madcatse/Retro-laptop-musicbox/documents/15pin_cable_pinout.png

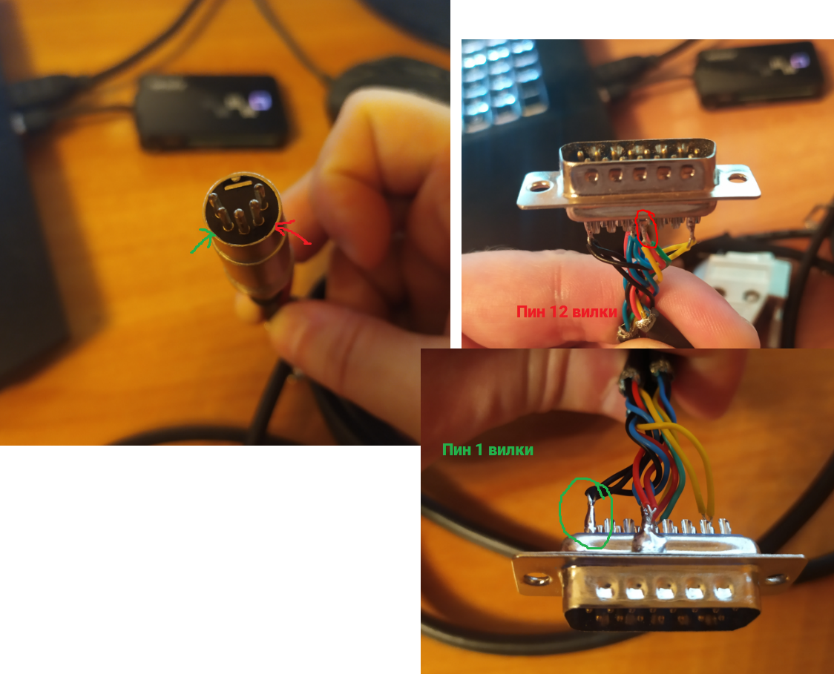
documents/15pin_cable_pinout.png
