madcatse/Retro-laptop-musicbox/README.md

# Retro-laptop-musicbox
 A stand-alone device that combines mt32-pi, LPT2MIDI and a COVOX
