madcatse/Retro-laptop-musicbox/documents/components_list.xlsx

Source: | C:\KICAD\projects\my_pcb\my_pcb.kicad_sch
Date: | 2023-03-08 17:43
Tool: | Eeschema (6.0.10)
Generator: | C:\Program Files\KiCad\6.0\bin\scripting\plugins/bom_csv_grouped_by_value.py
Component Count: | 72
Individual Components:
Item | Qty | Reference(s) | Value | LibPart | Footprint | Datasheet | Название
 |  | C1 | 470uF 25V | Device:C_Polarized | Capacitor_THT:CP_Radial_D10.0mm_P7.50mm | ~ | ECAP (К50-35), 470 мкФ, 25 В, 105°C, 10x12,5, B41851F5477M000, Конденсатор электролитический алюминиевый
 |  | C2 | 470uF 25V | Device:C_Polarized | Capacitor_THT:CP_Radial_D10.0mm_P7.50mm | ~ | ECAP (К50-35), 470 мкФ, 25 В, 105°C, 10x12,5, B41851F5477M000, Конденсатор электролитический алюминиевый
 |  | C3 | 0.1uF | Device:C | Capacitor_THT:C_Disc_D4.7mm_W2.5mm_P5.00mm | https://static.chipdip.ru/lib/056/DOC000056282.pdf | К10-17Б 0.1 мкФ X7R,10%, 0805, Конденсатор керамический выводной
 |  | C4 | 1000uF 25V | Device:C_Polarized | Capacitor_THT:CP_Radial_D10.0mm_P7.50mm | ~ | ECAP (К50-35), 1000 мкФ, 25 В, 105°C, 10x20, B41851A5108M000, Конденсатор электролитический алюминиевый
 |  | C5 | 0.1uF | Device:C | Capacitor_THT:C_Disc_D4.7mm_W2.5mm_P5.00mm | https://static.chipdip.ru/lib/056/DOC000056282.pdf | К10-17Б 0.1 мкФ X7R,10%, 0805, Конденсатор керамический выводной
 |  | C6 | 0.1uF | Device:C | Capacitor_THT:C_Disc_D4.7mm_W2.5mm_P5.00mm | https://static.chipdip.ru/lib/056/DOC000056282.pdf | К10-17Б 0.1 мкФ X7R,10%, 0805, Конденсатор керамический выводной
 |  | C7 | 1000uF 25V | Device:C_Polarized | Capacitor_THT:CP_Radial_D10.0mm_P7.50mm | ~ | ECAP (К50-35), 1000 мкФ, 25 В, 105°C, 10x20, B41851A5108M000, Конденсатор электролитический алюминиевый
 |  | C8 | 470pF | Device:C | Capacitor_THT:C_Disc_D4.7mm_W2.5mm_P5.00mm | https://static.chipdip.ru/lib/056/DOC000056282.pdf | К10-17Б 470пФ NPO,5%,0805, Конденсатор керамический выводной
 |  | C9 | 10uF 16V | Device:C_Polarized | Capacitor_THT:CP_Radial_D5.0mm_P2.00mm | https://static.chipdip.ru/lib/279/DOC000279577.pdf | ECAP (К50-35), 10мкФ, 16В, 105°C, 20%, 5x11мм P:2мм, Конденсатор электролитический алюминиевый
 |  | C10 | 100uF 63V | Device:C_Polarized | Capacitor_THT:CP_Radial_D10.0mm_P5.00mm | https://static.chipdip.ru/lib/279/DOC000279577.pdf | ECAP (К50-35), 100мкФ, 63В, 105°C, 20%, 10x12мм P:5мм, Конденсатор электролитический алюминиевый
 |  | C11 | 0.1uF | Device:C | Capacitor_THT:C_Disc_D4.7mm_W2.5mm_P5.00mm | https://static.chipdip.ru/lib/056/DOC000056282.pdf | К10-17Б 0.1 мкФ X7R,10%, 0805, Конденсатор керамический выводной
 |  | C12 | 0.1uF | Device:C | Capacitor_THT:C_Disc_D4.7mm_W2.5mm_P5.00mm | https://static.chipdip.ru/lib/056/DOC000056282.pdf | К10-17Б 0.1 мкФ X7R,10%, 0805, Конденсатор керамический выводной
 |  | C13 | 33nF | Device:C | Capacitor_THT:C_Disc_D4.7mm_W2.5mm_P5.00mm | https://static.chipdip.ru/lib/056/DOC000056282.pdf | К10-17Б 0.033мкФ X7R,10%,0805, Конденсатор керамический выводной
 |  | C14 | 10uF 16V | Device:C_Polarized | Capacitor_THT:CP_Radial_D5.0mm_P2.00mm | https://static.chipdip.ru/lib/279/DOC000279577.pdf | ECAP (К50-35), 10мкФ, 16В, 105°C, 20%, 5x11мм P:2мм, Конденсатор электролитический алюминиевый
 |  | C15 | 0.01uF | Device:C | Capacitor_THT:C_Disc_D4.7mm_W2.5mm_P5.00mm | https://static.chipdip.ru/lib/056/DOC000056282.pdf | К10-17Б 0.01 мкФ X7R,10%,0805, Конденсатор керамический выводной
 |  | C16 | 0.1uF | Device:C | Capacitor_THT:C_Disc_D4.7mm_W2.5mm_P5.00mm | https://static.chipdip.ru/lib/056/DOC000056282.pdf | К10-17Б 0.1 мкФ X7R,10%, 0805, Конденсатор керамический выводной
 |  | C17 | 1000uF 25V | Device:C_Polarized | Capacitor_THT:CP_Radial_D10.0mm_P7.50mm | ~ | ECAP (К50-35), 1000 мкФ, 25 В, 105°C, 10x20, B41851A5108M000, Конденсатор электролитический алюминиевый
 |  | C18 | 0.1uF | Device:C | Capacitor_THT:C_Disc_D4.7mm_W2.5mm_P5.00mm | https://static.chipdip.ru/lib/056/DOC000056282.pdf | К10-17Б 0.1 мкФ X7R,10%, 0805, Конденсатор керамический выводной
 |  | D1 | 1N4148 | Diode:1N4148 | Diode_THT:D_DO-35_SOD27_P7.62mm_Horizontal | https://static.chipdip.ru/lib/007/DOC003007981.pdf | 1N4148, Диод 150мА 100В [DO-35]
 |  | D2 | 1N4148 | Diode:1N4148 | Diode_THT:D_DO-35_SOD27_P7.62mm_Horizontal | https://static.chipdip.ru/lib/007/DOC003007981.pdf | 1N4148, Диод 150мА 100В [DO-35]
 |  | D3 | 1N4004 | Diode:1N4004 | Diode_THT:D_DO-41_SOD81_P10.16mm_Horizontal | http://www.vishay.com/docs/88503/1n4001.pdf | 1N4004, Диод выпрямительный 1А 400В [DO-41]
 |  | J1 | 12V Input Barrel | Connector:Barrel_Jack_MountingPin | w_conn_av:BarrelJack_GCT_DCJ200-10-A_Horizontal | https://static.chipdip.ru/lib/485/DOC014485047.pdf | DJK-02A (L-KLS1-DC-005A-2.0), Гнездо питания на плату 2,0х9мм
 |  | J2 | DB25_Male_MountingHoles | Connector:DB25_Male_MountingHoles | Connector_Dsub:DSUB-25_Male_Horizontal_P2.77x2.84mm_EdgePinOffset7.70mm_Housed_MountingHolesOffset9.12mm | https://static.chipdip.ru/lib/584/DOC000584749.pdf | DRB-25MA разъем типа D-SAB серии DRB, M-вилка угловая
 |  | J3 | MIDI IN | Connector:DIN-5_180degree | w_conn_av:DIN-5-Variable | http://www.mouser.com/ds/2/18/40_c091_abd_e-75918.pdf | Разъем DIN 5HP[45] розетка, на блок, GM-545-4
 |  | J4 | Main Board Connector | Connector_Generic:Conn_02x08_Odd_Even | Connector_PinHeader_2.54mm:PinHeader_2x08_P2.54mm_Vertical | ~
 |  | J5 | DB25_Male_MountingHoles | Connector:DB25_Male_MountingHoles | Connector_Dsub:DSUB-25_Male_Horizontal_P2.77x2.84mm_EdgePinOffset7.70mm_Housed_MountingHolesOffset9.12mm | https://static.chipdip.ru/lib/584/DOC000584749.pdf | DRB-25MA разъем типа D-SAB серии DRB, M-вилка угловая
 |  | J6 | Jack_3.5mm_5pin | w_connectors:AudioJack_5_pin | w_conn_av:jack_5_pin_3f07_FINAL |  | CKX3-3.5-06 гнездо на плату
 |  | J7 | Jack_3.5mm_5pin | w_connectors:AudioJack_5_pin | w_conn_av:jack_5_pin_3f07_FINAL |  | CKX3-3.5-06 гнездо на плату
 |  | J8 | Faceplate connector | Connector_Generic:Conn_02x08_Odd_Even | Connector_PinHeader_2.54mm:PinHeader_2x08_P2.54mm_Vertical | ~
 |  | J9 | DAC BOARD | Connector_Generic:Conn_01x15 | w_conn_av:PCM5102_full | ~ | Интерфейс I2S PCM5102A DAC декодер
 |  | J10 | SCREEN | Connector_Generic:Conn_01x04 | Connector_PinHeader_2.54mm:PinHeader_1x04_P2.54mm_Vertical | ~ | PBS-4 (DS-1023 - 1x4), Гнездо на плату 2.54мм 1х4pin прямое
 |  | J11 | ENCODER | Connector_Generic:Conn_01x06 | Connector_PinHeader_2.54mm:PinHeader_1x06_P2.54mm_Vertical | ~ | PLS-6 (DS1021-1*6SF112), Вилка штыревая 2.54мм 1x6pin прямая тип12
 |  | Pi1 | Raspberry_Pi_2_3 | Connector:Raspberry_Pi_2_3 | Connector_PinHeader_2.54mm:PinHeader_2x20_P2.54mm_Vertical | https://www.raspberrypi.org/documentation/hardware/raspberrypi/schematics/rpi_SCH_3bplus_1p0_reduced.pdf | PBD-40 (DS1023-2X20), Гнездо на плату 2.54мм 2х20pin прямое
 |  | R1 | 220 | Device:R | Resistor_THT:R_Axial_DIN0207_L6.3mm_D2.5mm_P10.16mm_Horizontal | ~ | MF-25 (С2-23) 0.25 Вт, 220 Ом, 1%, Резистор металлопленочный
 |  | R2 | 220 | Device:R | Resistor_THT:R_Axial_DIN0207_L6.3mm_D2.5mm_P10.16mm_Horizontal | ~ | MF-25 (С2-23) 0.25 Вт, 220 Ом, 1%, Резистор металлопленочный
 |  | R3 | 240 | Device:R | Resistor_THT:R_Axial_DIN0207_L6.3mm_D2.5mm_P10.16mm_Horizontal | ~ | MF-25 (С2-23) 0.25 Вт, 240 Ом, 1%, Резистор металлопленочный
 |  | R4 | 1K | Device:R | Resistor_THT:R_Axial_DIN0207_L6.3mm_D2.5mm_P10.16mm_Horizontal | ~ | MF-25 (С2-23) 0.25 Вт, 1 кОм, 1%, Резистор металлопленочный
 |  | R5 | 20K | Device:R | Resistor_THT:R_Axial_DIN0207_L6.3mm_D2.5mm_P10.16mm_Horizontal | ~ | MF-25 (С2-23) 0.25 Вт, 20 кОм, 1%, Резистор металлопленочный
 |  | R6 | 20K | Device:R | Resistor_THT:R_Axial_DIN0207_L6.3mm_D2.5mm_P10.16mm_Horizontal | ~ | MF-25 (С2-23) 0.25 Вт, 20 кОм, 1%, Резистор металлопленочный
 |  | R7 | 20K | Device:R | Resistor_THT:R_Axial_DIN0207_L6.3mm_D2.5mm_P10.16mm_Horizontal | ~ | MF-25 (С2-23) 0.25 Вт, 20 кОм, 1%, Резистор металлопленочный
 |  | R8 | 20K | Device:R | Resistor_THT:R_Axial_DIN0207_L6.3mm_D2.5mm_P10.16mm_Horizontal | ~ | MF-25 (С2-23) 0.25 Вт, 20 кОм, 1%, Резистор металлопленочный
 |  | R9 | 20K | Device:R | Resistor_THT:R_Axial_DIN0207_L6.3mm_D2.5mm_P10.16mm_Horizontal | ~ | MF-25 (С2-23) 0.25 Вт, 20 кОм, 1%, Резистор металлопленочный
 |  | R10 | 20K | Device:R | Resistor_THT:R_Axial_DIN0207_L6.3mm_D2.5mm_P10.16mm_Horizontal | ~ | MF-25 (С2-23) 0.25 Вт, 20 кОм, 1%, Резистор металлопленочный
 |  | R11 | 20K | Device:R | Resistor_THT:R_Axial_DIN0207_L6.3mm_D2.5mm_P10.16mm_Horizontal | ~ | MF-25 (С2-23) 0.25 Вт, 20 кОм, 1%, Резистор металлопленочный
 |  | R12 | 20K | Device:R | Resistor_THT:R_Axial_DIN0207_L6.3mm_D2.5mm_P10.16mm_Horizontal | ~ | MF-25 (С2-23) 0.25 Вт, 20 кОм, 1%, Резистор металлопленочный
 |  | R13 | 20K | Device:R | Resistor_THT:R_Axial_DIN0207_L6.3mm_D2.5mm_P10.16mm_Horizontal | ~ | MF-25 (С2-23) 0.25 Вт, 20 кОм, 1%, Резистор металлопленочный
 |  | R14 | 10K | Device:R | Resistor_THT:R_Axial_DIN0207_L6.3mm_D2.5mm_P10.16mm_Horizontal | ~ | MF-25 (С2-23) 0.25 Вт, 10 кОм, 1%, Резистор металлопленочный
 |  | R15 | 10K | Device:R | Resistor_THT:R_Axial_DIN0207_L6.3mm_D2.5mm_P10.16mm_Horizontal | ~ | MF-25 (С2-23) 0.25 Вт, 10 кОм, 1%, Резистор металлопленочный
 |  | R16 | 10K | Device:R | Resistor_THT:R_Axial_DIN0207_L6.3mm_D2.5mm_P10.16mm_Horizontal | ~ | MF-25 (С2-23) 0.25 Вт, 10 кОм, 1%, Резистор металлопленочный
 |  | R17 | 10K | Device:R | Resistor_THT:R_Axial_DIN0207_L6.3mm_D2.5mm_P10.16mm_Horizontal | ~ | MF-25 (С2-23) 0.25 Вт, 10 кОм, 1%, Резистор металлопленочный
 |  | R18 | 10K | Device:R | Resistor_THT:R_Axial_DIN0207_L6.3mm_D2.5mm_P10.16mm_Horizontal | ~ | MF-25 (С2-23) 0.25 Вт, 10 кОм, 1%, Резистор металлопленочный
 |  | R19 | 10K | Device:R | Resistor_THT:R_Axial_DIN0207_L6.3mm_D2.5mm_P10.16mm_Horizontal | ~ | MF-25 (С2-23) 0.25 Вт, 10 кОм, 1%, Резистор металлопленочный
 |  | R20 | 10K | Device:R | Resistor_THT:R_Axial_DIN0207_L6.3mm_D2.5mm_P10.16mm_Horizontal | ~ | MF-25 (С2-23) 0.25 Вт, 10 кОм, 1%, Резистор металлопленочный
 |  | R21 | 10K | Device:R | Resistor_THT:R_Axial_DIN0207_L6.3mm_D2.5mm_P10.16mm_Horizontal | ~ | MF-25 (С2-23) 0.25 Вт, 10 кОм, 1%, Резистор металлопленочный
 |  | R22 | 10K | Device:R | Resistor_THT:R_Axial_DIN0207_L6.3mm_D2.5mm_P10.16mm_Horizontal | ~ | MF-25 (С2-23) 0.25 Вт, 10 кОм, 1%, Резистор металлопленочный
 |  | R23 | 10 | Device:R | Resistor_THT:R_Axial_DIN0207_L6.3mm_D2.5mm_P10.16mm_Horizontal | ~ | MF-25 (С2-23) 0.25 Вт, 10 Ом, 1%, Резистор металлопленочный
 |  | RV1 | 5K | Device:R_Potentiometer | Potentiometer_THT:Potentiometer_Runtron_RM-065_Vertical | ~ | 3362H-1-502LF (СП3-19а), 5 кОм, Резистор подстроечный
 |  | RV2 | 10K | Device:R_Potentiometer | Potentiometer_THT:Potentiometer_Alpha_RD901F-40-00D_Single_Vertical_CircularHoles | https://static.chipdip.ru/lib/178/DOC000178818.pdf | PTV09A-4225F-B103, 10 кОм, Резистор переменный
 |  | RV3 | 10K | Device:R_Potentiometer | Potentiometer_THT:Potentiometer_Alpha_RD901F-40-00D_Single_Vertical_CircularHoles | https://static.chipdip.ru/lib/178/DOC000178818.pdf | PTV09A-4225F-B103, 10 кОм, Резистор переменный
 |  | RV4 | 10K | Device:R_Potentiometer | Potentiometer_THT:Potentiometer_Alpha_RD901F-40-00D_Single_Vertical_CircularHoles | https://static.chipdip.ru/lib/178/DOC000178818.pdf | PTV09A-4225F-B103, 10 кОм, Резистор переменный
 |  | SW1 | SW_SPDT | Switch:SW_SPDT | w_conn_av:MTS-102-C3 | ~ | MTS-102-C3, Тумблер ON-ON (3A 250VAC) SPDT 3P
 |  | SW2 | SW_DPDT_x2 | Switch:SW_DPDT_x2 | w_conn_av:SW_CuK_JS202011AQN_DPDT_Angled2 | ~ | Переключатель движковый, 13x 7h3.5
 |  | SW3 | VOL.DOWN | Switch:SW_Push | Button_Switch_THT:SW_PUSH_6mm | ~ | KLS7-TS6601-11-180 (IT-1102K), Кнопка тактовая прямая 6х6х11мм 4pin
 |  | SW4 | VOL.UP | Switch:SW_Push | Button_Switch_THT:SW_PUSH_6mm | ~ | KLS7-TS6601-11-180 (IT-1102K), Кнопка тактовая прямая 6х6х11мм 4pin
 |  | SW5 | MT32/SF | Switch:SW_Push | Button_Switch_THT:SW_PUSH_6mm | ~ | KLS7-TS6601-11-180 (IT-1102K), Кнопка тактовая прямая 6х6х11мм 4pin
 |  | SW6 | SYNTH | Switch:SW_Push | Button_Switch_THT:SW_PUSH_6mm | ~ | KLS7-TS6601-11-180 (IT-1102K), Кнопка тактовая прямая 6х6х11мм 4pin
 |  | SW7 | RotaryEncoder_Switch | Device:RotaryEncoder_Switch | Rotary_Encoder:RotaryEncoder_Alps_EC11E-Switch_Vertical_H20mm | ~
 |  | U1 | Arduino_Nano | Arduino:Arduino_Nano | w_conn_av:Arduino_Nano | https://store.arduino.cc/usa/arduino-nano | Программируемый контроллер на базе ATmega328P Arduino Nano
 |  | U2 | LM7809_TO220 | Regulator_Linear:LM7809_TO220 | Package_TO_SOT_THT:TO-220-3_Vertical | https://www.onsemi.cn/PowerSolutions/document/MC7800-D.PDF | LM7809 стабилизатор напряжения; линейный,нерегулируемый; 9В; 2А
 |  | U3 | LM338_TO-220 | Regulator_Linear:LM317_TO-220 | Package_TO_SOT_THT:TO-220-3_Vertical | http://www.ti.com/lit/ds/symlink/lm317.pdf | LM338T/NOPB, Регулируемый стабилизатор напряжения, 5А, 1.2В…32В, [TO-220]
 |  | U4 | H11L1 | Isolator:H11L1 | Package_DIP:DIP-6_W7.62mm | https://www.onsemi.com/pub/Collateral/H11L3M-D.PDF | H11L1M, Оптопара с выходом на триггере Шмитта [DIP-6]
 |  | U5 | LM386 | Amplifier_Audio:LM386 | Package_DIP:DIP-8_W7.62mm | http://www.ti.com/lit/ds/symlink/lm386.pdf | LM386N-1/NOPB, Низковольтный аудиоусилитель для портативной аппаратуры, 4В…12В, 4мА, 325мВт, 8 Ом, [DIP-8]
Collated Components:
Item | Qty | Reference(s) | Value | LibPart | Footprint | Datasheet | Название
1 | 2 | C1, C2 | 470uF 25V | Device:C_Polarized | Capacitor_THT:CP_Radial_D10.0mm_P7.50mm | ~ | ECAP (К50-35), 470 мкФ, 25 В, 105°C, 10x12,5, B41851F5477M000, Конденсатор электролитический алюминиевый
2 | 7 | C3, C5, C6, C11, C12, C16, C18 | 0.1uF | Device:C | Capacitor_THT:C_Disc_D4.7mm_W2.5mm_P5.00mm | https://static.chipdip.ru/lib/056/DOC000056282.pdf | К10-17Б 0.1 мкФ X7R,10%, 0805, Конденсатор керамический выводной
3 | 3 | C4, C7, C17 | 1000uF 25V | Device:C_Polarized | Capacitor_THT:CP_Radial_D10.0mm_P7.50mm | ~ | ECAP (К50-35), 1000 мкФ, 25 В, 105°C, 10x20, B41851A5108M000, Конденсатор электролитический алюминиевый
4 | 1 | C8 | 470pF | Device:C | Capacitor_THT:C_Disc_D4.7mm_W2.5mm_P5.00mm | https://static.chipdip.ru/lib/056/DOC000056282.pdf | К10-17Б 470пФ NPO,5%,0805, Конденсатор керамический выводной
5 | 2 | C9, C14 | 10uF 16V | Device:C_Polarized | Capacitor_THT:CP_Radial_D5.0mm_P2.00mm | https://static.chipdip.ru/lib/279/DOC000279577.pdf | ECAP (К50-35), 10мкФ, 16В, 105°C, 20%, 5x11мм P:2мм, Конденсатор электролитический алюминиевый
6 | 1 | C10 | 100uF 63V | Device:C_Polarized | Capacitor_THT:CP_Radial_D10.0mm_P5.00mm | https://static.chipdip.ru/lib/279/DOC000279577.pdf | ECAP (К50-35), 100мкФ, 63В, 105°C, 20%, 10x12мм P:5мм, Конденсатор электролитический алюминиевый
7 | 1 | C13 | 33nF | Device:C | Capacitor_THT:C_Disc_D4.7mm_W2.5mm_P5.00mm | https://static.chipdip.ru/lib/056/DOC000056282.pdf | К10-17Б 0.033мкФ X7R,10%,0805, Конденсатор керамический выводной
8 | 1 | C15 | 0.01uF | Device:C | Capacitor_THT:C_Disc_D4.7mm_W2.5mm_P5.00mm | https://static.chipdip.ru/lib/056/DOC000056282.pdf | К10-17Б 0.01 мкФ X7R,10%,0805, Конденсатор керамический выводной
9 | 2 | D1, D2 | 1N4148 | Diode:1N4148 | Diode_THT:D_DO-35_SOD27_P7.62mm_Horizontal | https://static.chipdip.ru/lib/007/DOC003007981.pdf | 1N4148, Диод 150мА 100В [DO-35]
10 | 1 | D3 | 1N4004 | Diode:1N4004 | Diode_THT:D_DO-41_SOD81_P10.16mm_Horizontal | http://www.vishay.com/docs/88503/1n4001.pdf | 1N4004, Диод выпрямительный 1А 400В [DO-41]
11 | 1 | J1 | 12V Input Barrel | Connector:Barrel_Jack_MountingPin | w_conn_av:BarrelJack_GCT_DCJ200-10-A_Horizontal | https://static.chipdip.ru/lib/485/DOC014485047.pdf | DJK-02A (L-KLS1-DC-005A-2.0), Гнездо питания на плату 2,0х9мм
12 | 2 | J2, J5 | DB25_Male_MountingHoles | Connector:DB25_Male_MountingHoles | Connector_Dsub:DSUB-25_Male_Horizontal_P2.77x2.84mm_EdgePinOffset7.70mm_Housed_MountingHolesOffset9.12mm | https://static.chipdip.ru/lib/584/DOC000584749.pdf | DRB-25MA разъем типа D-SAB серии DRB, M-вилка угловая
13 | 1 | J3 | MIDI IN | Connector:DIN-5_180degree | w_conn_av:DIN-5-Variable | http://www.mouser.com/ds/2/18/40_c091_abd_e-75918.pdf | Разъем DIN 5HP[45] розетка, на блок, GM-545-4
14 | 1 | J4 | Main Board Connector | Connector_Generic:Conn_02x08_Odd_Even | Connector_PinHeader_2.54mm:PinHeader_2x08_P2.54mm_Vertical | ~
15 | 2 | J6, J7 | Jack_3.5mm_5pin | w_connectors:AudioJack_5_pin | w_conn_av:jack_5_pin_3f07_FINAL |  | CKX3-3.5-06 гнездо на плату
16 | 1 | J8 | Faceplate connector | Connector_Generic:Conn_02x08_Odd_Even | Connector_PinHeader_2.54mm:PinHeader_2x08_P2.54mm_Vertical | ~
17 | 1 | J9 | DAC BOARD | Connector_Generic:Conn_01x15 | w_conn_av:PCM5102_full | ~ | Интерфейс I2S PCM5102A DAC декодер
18 | 1 | J10 | SCREEN | Connector_Generic:Conn_01x04 | Connector_PinHeader_2.54mm:PinHeader_1x04_P2.54mm_Vertical | ~ | PBS-4 (DS-1023 - 1x4), Гнездо на плату 2.54мм 1х4pin прямое
19 | 1 | J11 | ENCODER | Connector_Generic:Conn_01x06 | Connector_PinHeader_2.54mm:PinHeader_1x06_P2.54mm_Vertical | ~ | PLS-6 (DS1021-1*6SF112), Вилка штыревая 2.54мм 1x6pin прямая тип12
20 | 1 | Pi1 | Raspberry_Pi_2_3 | Connector:Raspberry_Pi_2_3 | Connector_PinHeader_2.54mm:PinHeader_2x20_P2.54mm_Vertical | https://www.raspberrypi.org/documentation/hardware/raspberrypi/schematics/rpi_SCH_3bplus_1p0_reduced.pdf | PBD-40 (DS1023-2X20), Гнездо на плату 2.54мм 2х20pin прямое
21 | 2 | R1, R2 | 220 | Device:R | Resistor_THT:R_Axial_DIN0207_L6.3mm_D2.5mm_P10.16mm_Horizontal | ~ | MF-25 (С2-23) 0.25 Вт, 220 Ом, 1%, Резистор металлопленочный
22 | 1 | R3 | 240 | Device:R | Resistor_THT:R_Axial_DIN0207_L6.3mm_D2.5mm_P10.16mm_Horizontal | ~ | MF-25 (С2-23) 0.25 Вт, 240 Ом, 1%, Резистор металлопленочный
23 | 1 | R4 | 1K | Device:R | Resistor_THT:R_Axial_DIN0207_L6.3mm_D2.5mm_P10.16mm_Horizontal | ~ | MF-25 (С2-23) 0.25 Вт, 1 кОм, 1%, Резистор металлопленочный
24 | 9 | R5, R6, R7, R8, R9, R10, R11, R12, R13 | 20K | Device:R | Resistor_THT:R_Axial_DIN0207_L6.3mm_D2.5mm_P10.16mm_Horizontal | ~ | MF-25 (С2-23) 0.25 Вт, 20 кОм, 1%, Резистор металлопленочный
25 | 9 | R14, R15, R16, R17, R18, R19, R20, R21, R22 | 10K | Device:R | Resistor_THT:R_Axial_DIN0207_L6.3mm_D2.5mm_P10.16mm_Horizontal | ~ | MF-25 (С2-23) 0.25 Вт, 10 кОм, 1%, Резистор металлопленочный
26 | 1 | R23 | 10 | Device:R | Resistor_THT:R_Axial_DIN0207_L6.3mm_D2.5mm_P10.16mm_Horizontal | ~ | MF-25 (С2-23) 0.25 Вт, 10 Ом, 1%, Резистор металлопленочный
27 | 1 | RV1 | 5K | Device:R_Potentiometer | Potentiometer_THT:Potentiometer_Runtron_RM-065_Vertical | ~ | 3362H-1-502LF (СП3-19а), 5 кОм, Резистор подстроечный
28 | 3 | RV2, RV3, RV4 | 10K | Device:R_Potentiometer | Potentiometer_THT:Potentiometer_Alpha_RD901F-40-00D_Single_Vertical_CircularHoles | https://static.chipdip.ru/lib/178/DOC000178818.pdf | PTV09A-4225F-B103, 10 кОм, Резистор переменный
29 | 1 | SW1 | SW_SPDT | Switch:SW_SPDT | w_conn_av:MTS-102-C3 | ~ | MTS-102-C3, Тумблер ON-ON (3A 250VAC) SPDT 3P
30 | 1 | SW2 | SW_DPDT_x2 | Switch:SW_DPDT_x2 | w_conn_av:SW_CuK_JS202011AQN_DPDT_Angled2 | ~ | Переключатель движковый, 13x 7h3.5
31 | 1 | SW3 | VOL.DOWN | Switch:SW_Push | Button_Switch_THT:SW_PUSH_6mm | ~ | KLS7-TS6601-11-180 (IT-1102K), Кнопка тактовая прямая 6х6х11мм 4pin
32 | 1 | SW4 | VOL.UP | Switch:SW_Push | Button_Switch_THT:SW_PUSH_6mm | ~ | KLS7-TS6601-11-180 (IT-1102K), Кнопка тактовая прямая 6х6х11мм 4pin
33 | 1 | SW5 | MT32/SF | Switch:SW_Push | Button_Switch_THT:SW_PUSH_6mm | ~ | KLS7-TS6601-11-180 (IT-1102K), Кнопка тактовая прямая 6х6х11мм 4pin
34 | 1 | SW6 | SYNTH | Switch:SW_Push | Button_Switch_THT:SW_PUSH_6mm | ~ | KLS7-TS6601-11-180 (IT-1102K), Кнопка тактовая прямая 6х6х11мм 4pin
35 | 1 | SW7 | RotaryEncoder_Switch | Device:RotaryEncoder_Switch | Rotary_Encoder:RotaryEncoder_Alps_EC11E-Switch_Vertical_H20mm | ~
36 | 1 | U1 | Arduino_Nano | Arduino:Arduino_Nano | w_conn_av:Arduino_Nano | https://store.arduino.cc/usa/arduino-nano | Программируемый контроллер на базе ATmega328P Arduino Nano
37 | 1 | U2 | LM7809_TO220 | Regulator_Linear:LM7809_TO220 | Package_TO_SOT_THT:TO-220-3_Vertical | https://www.onsemi.cn/PowerSolutions/document/MC7800-D.PDF | LM7809 стабилизатор напряжения; линейный,нерегулируемый; 9В; 2А
38 | 1 | U3 | LM338_TO-220 | Regulator_Linear:LM317_TO-220 | Package_TO_SOT_THT:TO-220-3_Vertical | http://www.ti.com/lit/ds/symlink/lm317.pdf | LM338T/NOPB, Регулируемый стабилизатор напряжения, 5А, 1.2В…32В, [TO-220]
39 | 1 | U4 | H11L1 | Isolator:H11L1 | Package_DIP:DIP-6_W7.62mm | https://www.onsemi.com/pub/Collateral/H11L3M-D.PDF | H11L1M, Оптопара с выходом на триггере Шмитта [DIP-6]
40 | 1 | U5 | LM386 | Amplifier_Audio:LM386 | Package_DIP:DIP-8_W7.62mm | http://www.ti.com/lit/ds/symlink/lm386.pdf | LM386N-1/NOPB, Низковольтный аудиоусилитель для портативной аппаратуры, 4В…12В, 4мА, 325мВт, 8 Ом, [DIP-8]
