madcatse/Retro-laptop-musicbox/documents/retro_laptop_musicbox.dxf

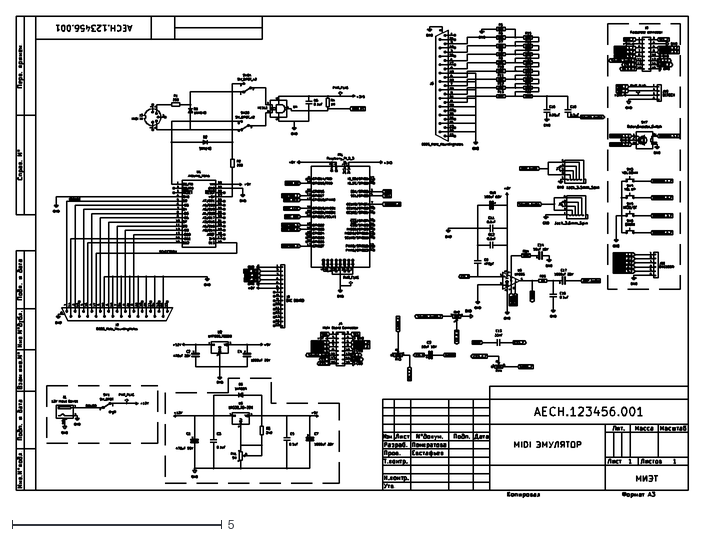
[picture p2: CAD file, 2023-03-26]
documents/retro_laptop_musicbox.dxf
16.0 x 11.5
