madcatse/Retro-laptop-musicbox/shapes3D/CUI_DEVICES_SJ1-3523N.STL

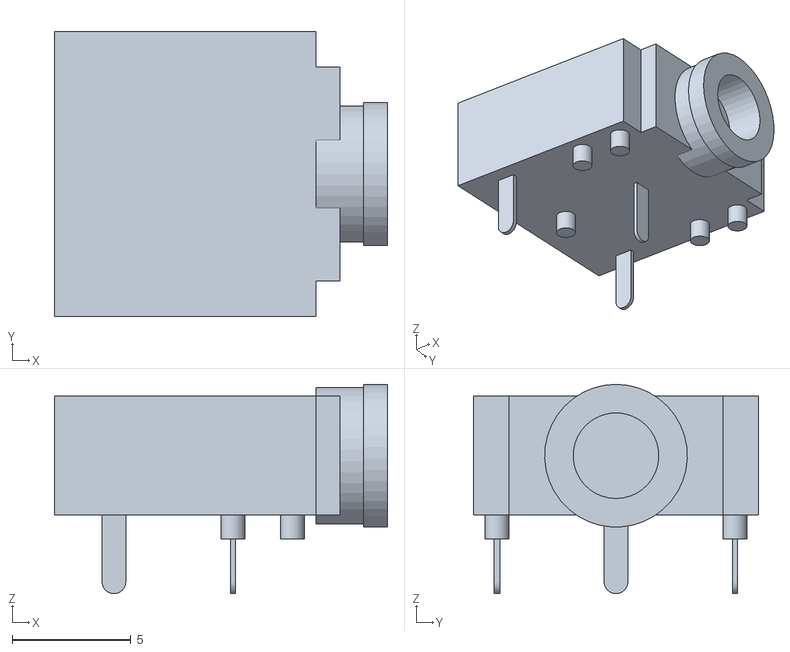
[picture p3: CAD file, 2023-07-18]
shapes3D/CUI_DEVICES_SJ1-3523N.STL
14.0 x 12.0 x 8.80
