madcatse/Retro-laptop-musicbox/documents/структурная_схема.dxf

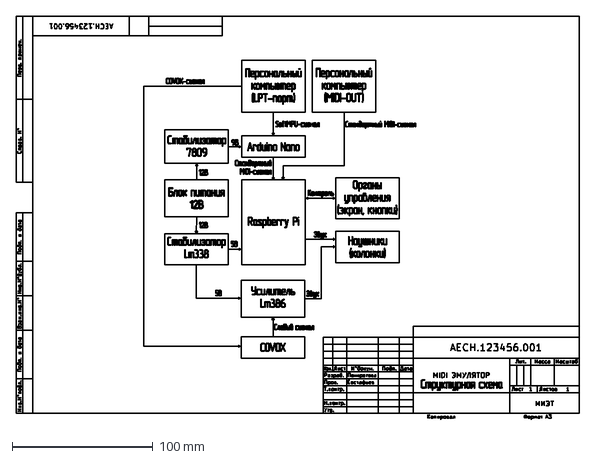
[picture p4: CAD file, 2023-03-26]
documents/структурная_схема.dxf
400.6 x 286.9 mm
