madcatse/Retro-laptop-musicbox/(list of files, cad)

Other CAD files:
shapes3D/minijack.STEP
