madcatse/Retro-laptop-musicbox/To fix.docx

Необходимо пофиксить:

1. Кнопки соединить с землей
2. Исправить направление разъема на панели с переда на зад
3. Тумблер «миди-лпт» переключает не в ту сторону
4. Кнопка включения/выключения не удобная, выключать неудобно
5. Монтажные отверстия побольше
6. Отдельную землю под усилитель? Собрать на отдельной плате?
