madcatse/Retro-laptop-musicbox/documents/структурная_схема.pdf

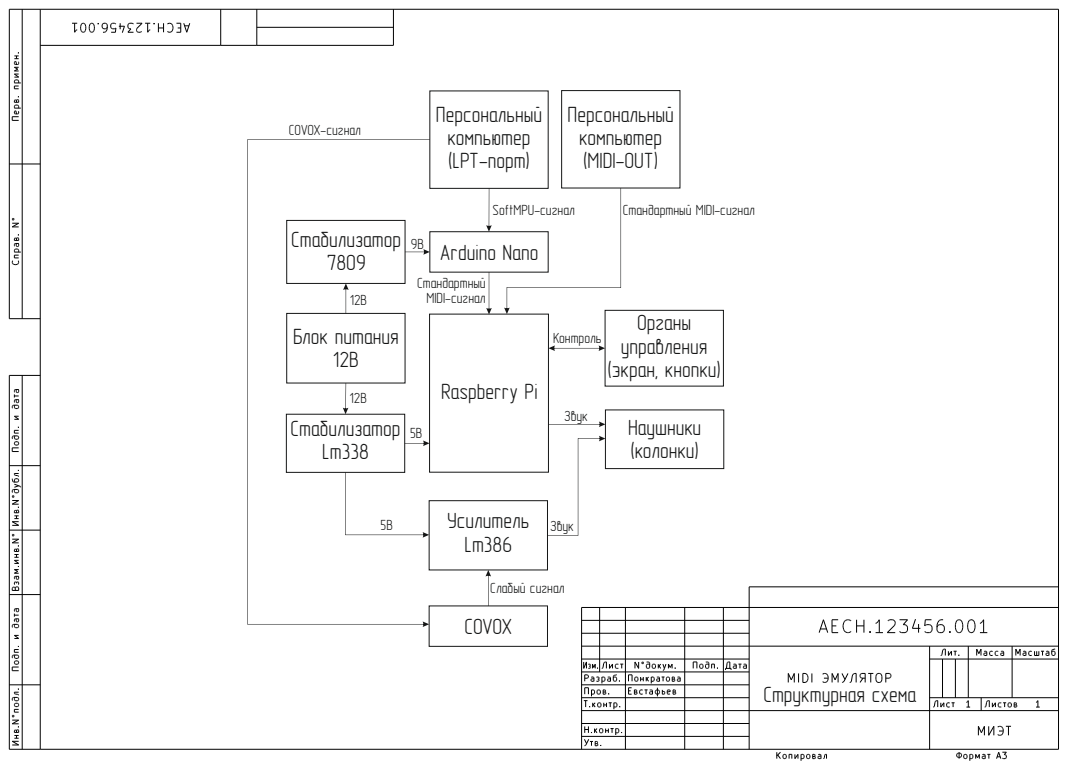
[picture p5: page 1]
Raspberry Pi; Arduino Nano; Áëîê ïèòàíèÿ 12Â; Ñòàáèëèçàòîð 7809; Ñòàáèëèçàòîð Lm338; Ïåðñîíàëüíûé êîìïüþòåð (MIDI-OUT); Ïåðñîíàëüíûé êîìïüþòåð (LPT-ïîðò); Îðãàíû óïðàâëåíèÿ (ýêðàí, êíîïêè); Íàóøíèêè (êîëîíêè); COVOX; Óñèëèòåëü Lm386; Ñòðóêòóðíàÿ ñõåìà; SoftMPU-ñèãíàë; Ñòàíäàðòíûé MIDI-ñèãíàë; COVOX-ñèãíàë; Çâóê; Êîíòðîëü; Ñòàíäàðòíûé; MIDI-ñèãíàë; Ñëàáûé ñèãíàë
