madcatse/Retro-laptop-musicbox/documents/topology.pdf

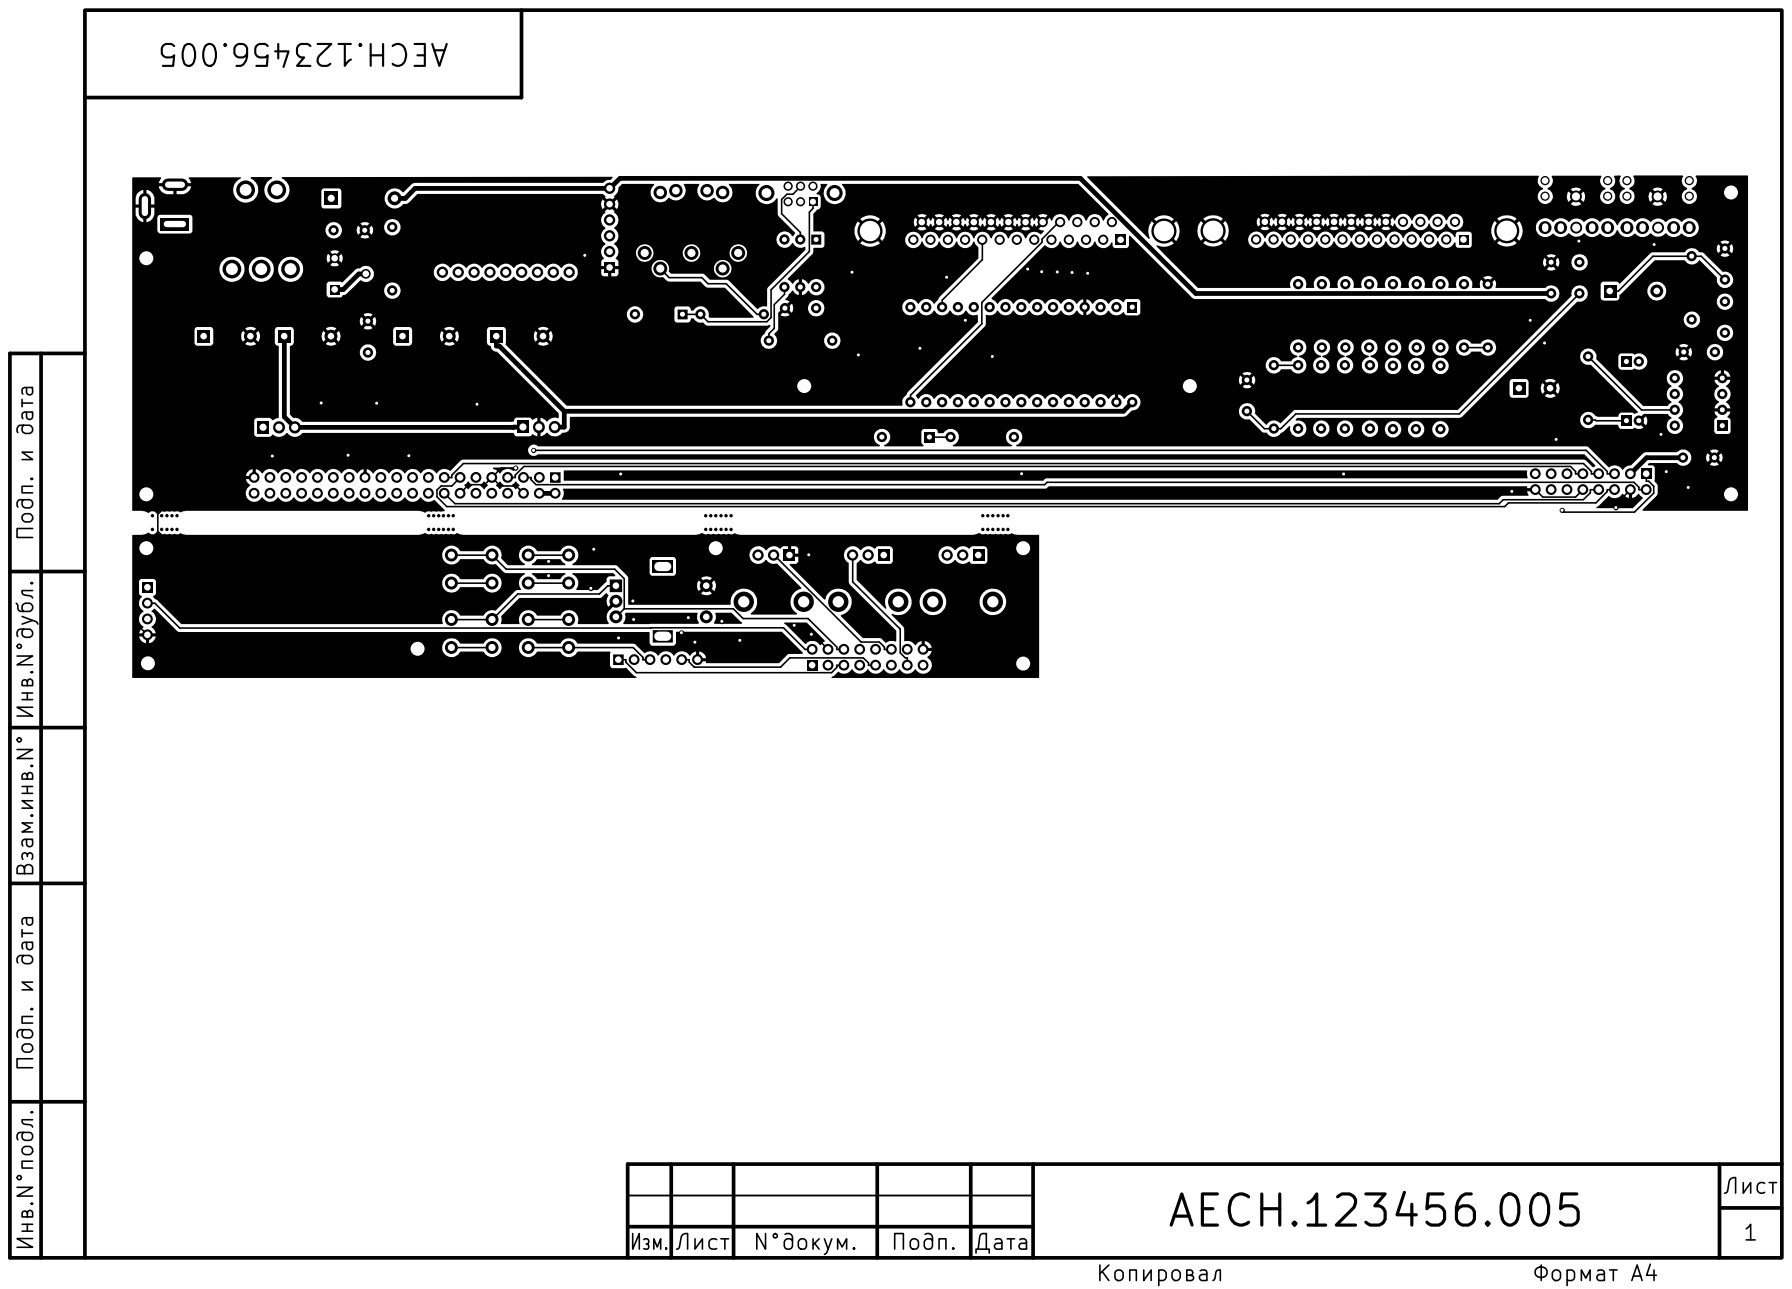
[picture p6: page 1]

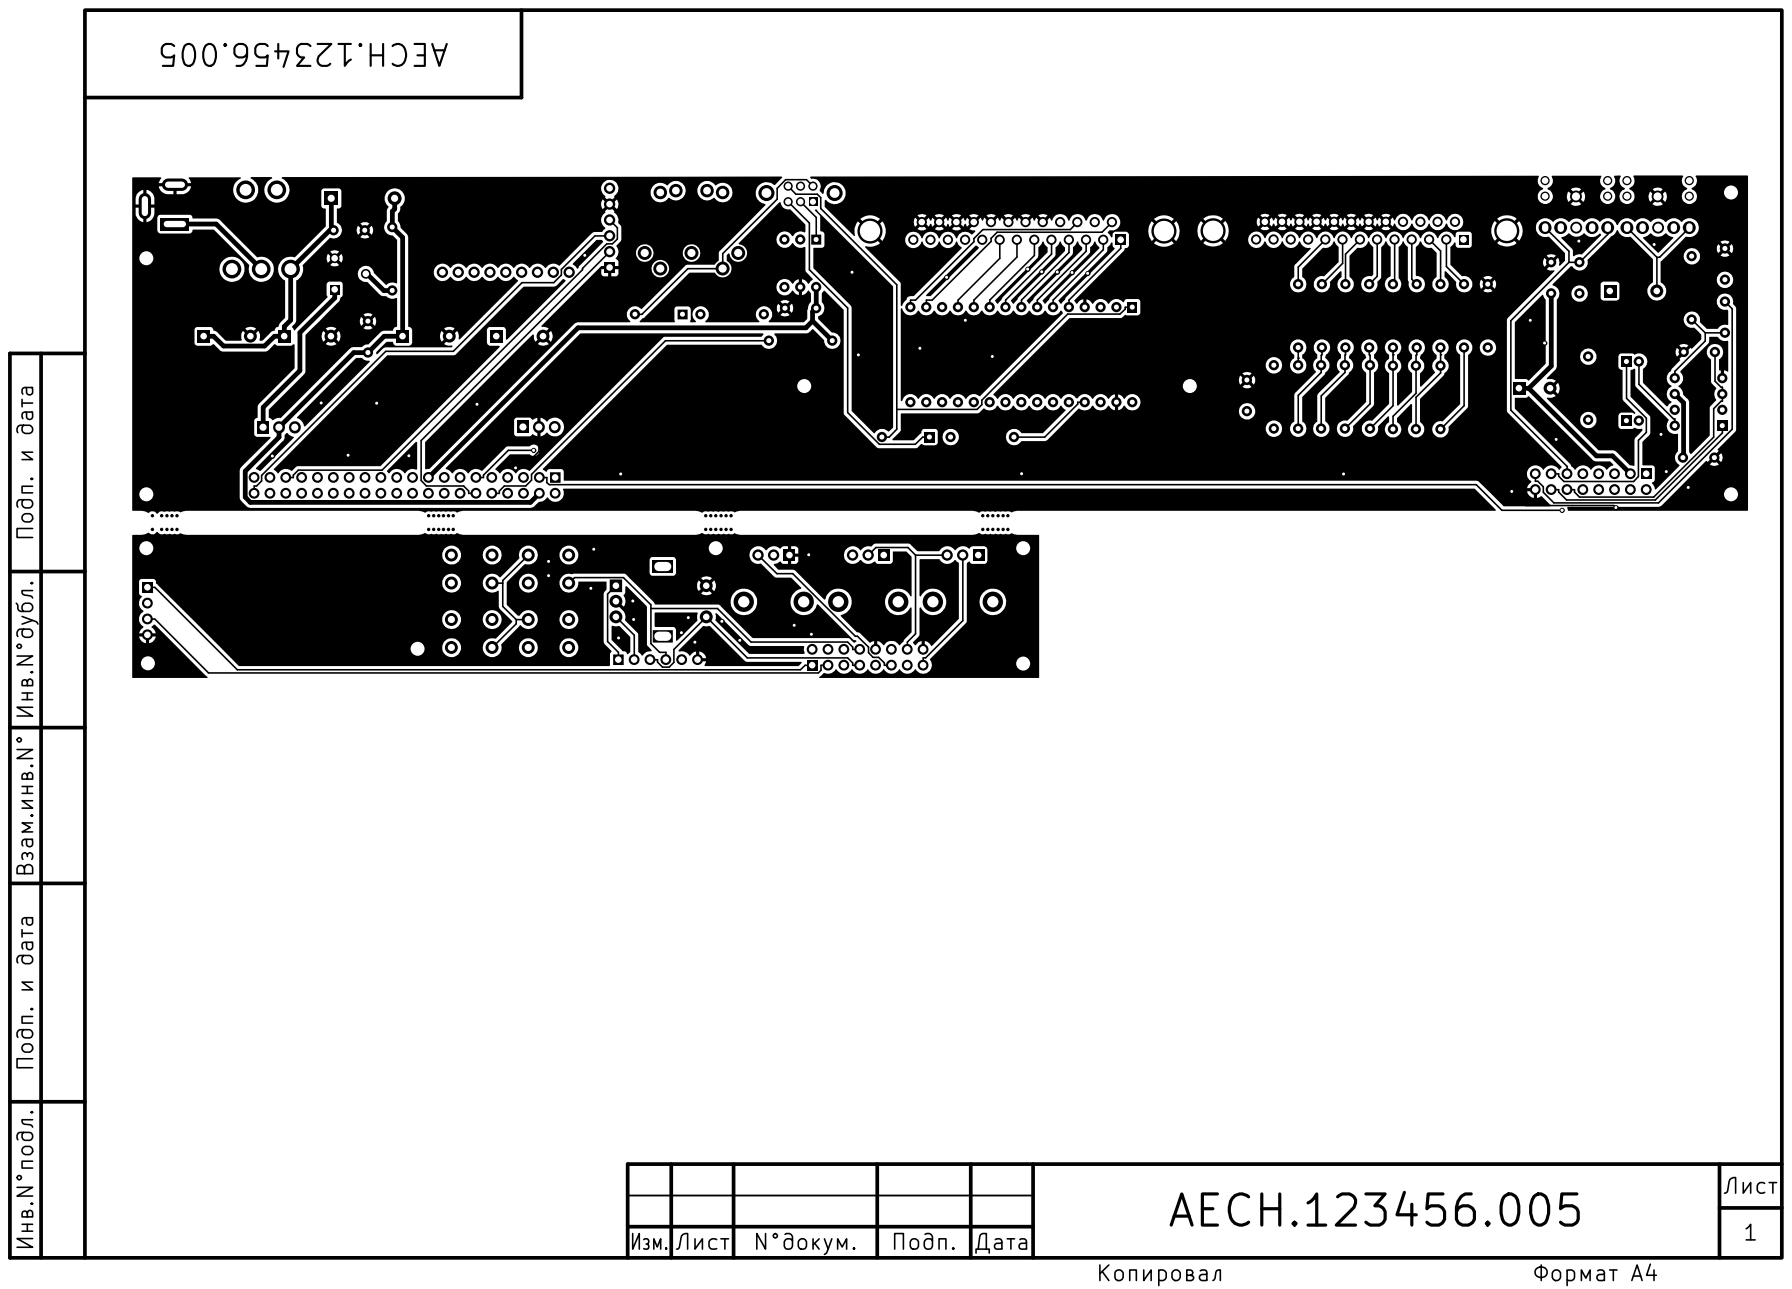
[picture p7: page 2]

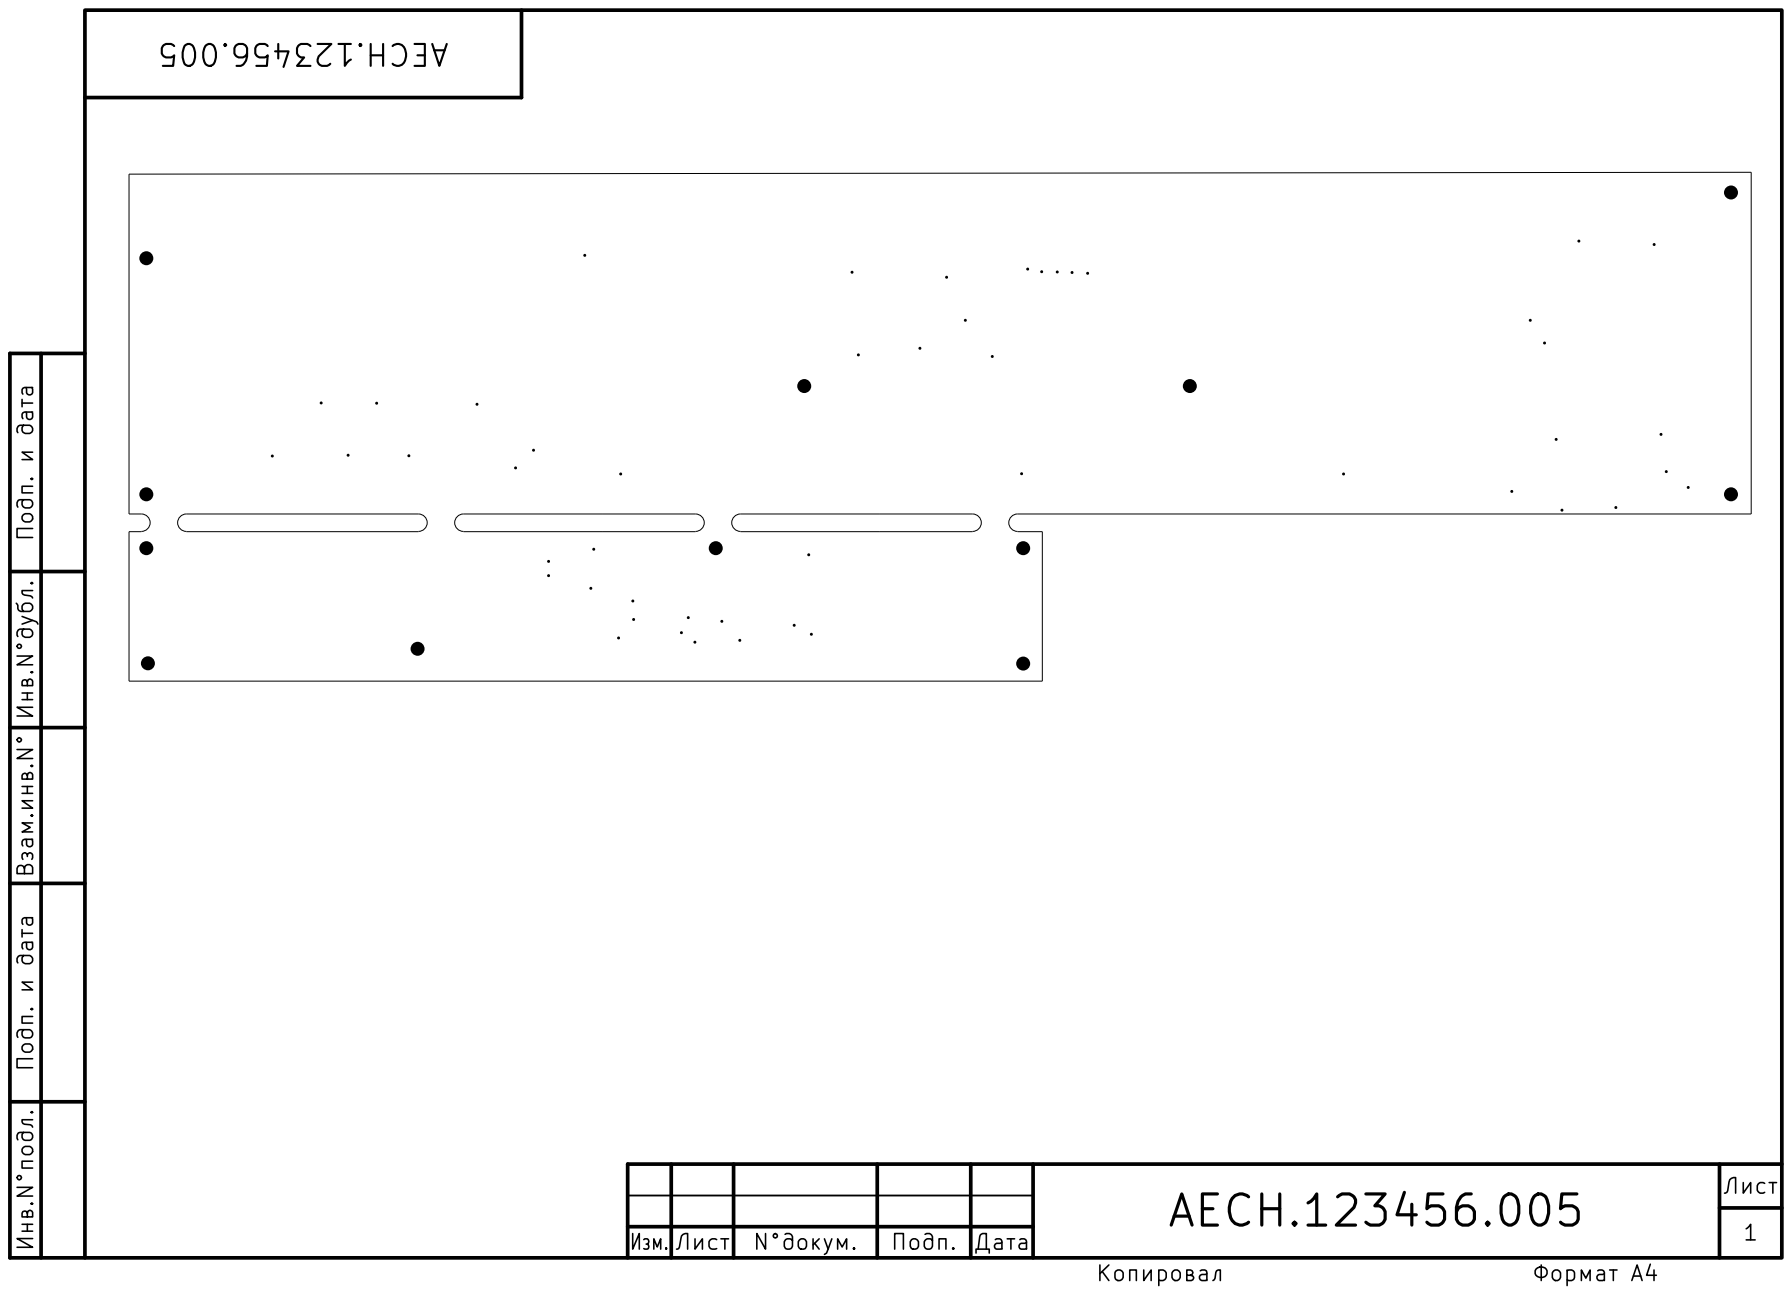
[picture p8: page 3]
