madcatse/Retro-laptop-musicbox/retro_laptop_musicbox.kicad_pcb

## KiCad design retro_laptop_musicbox.kicad_pcb (2023-07-18)

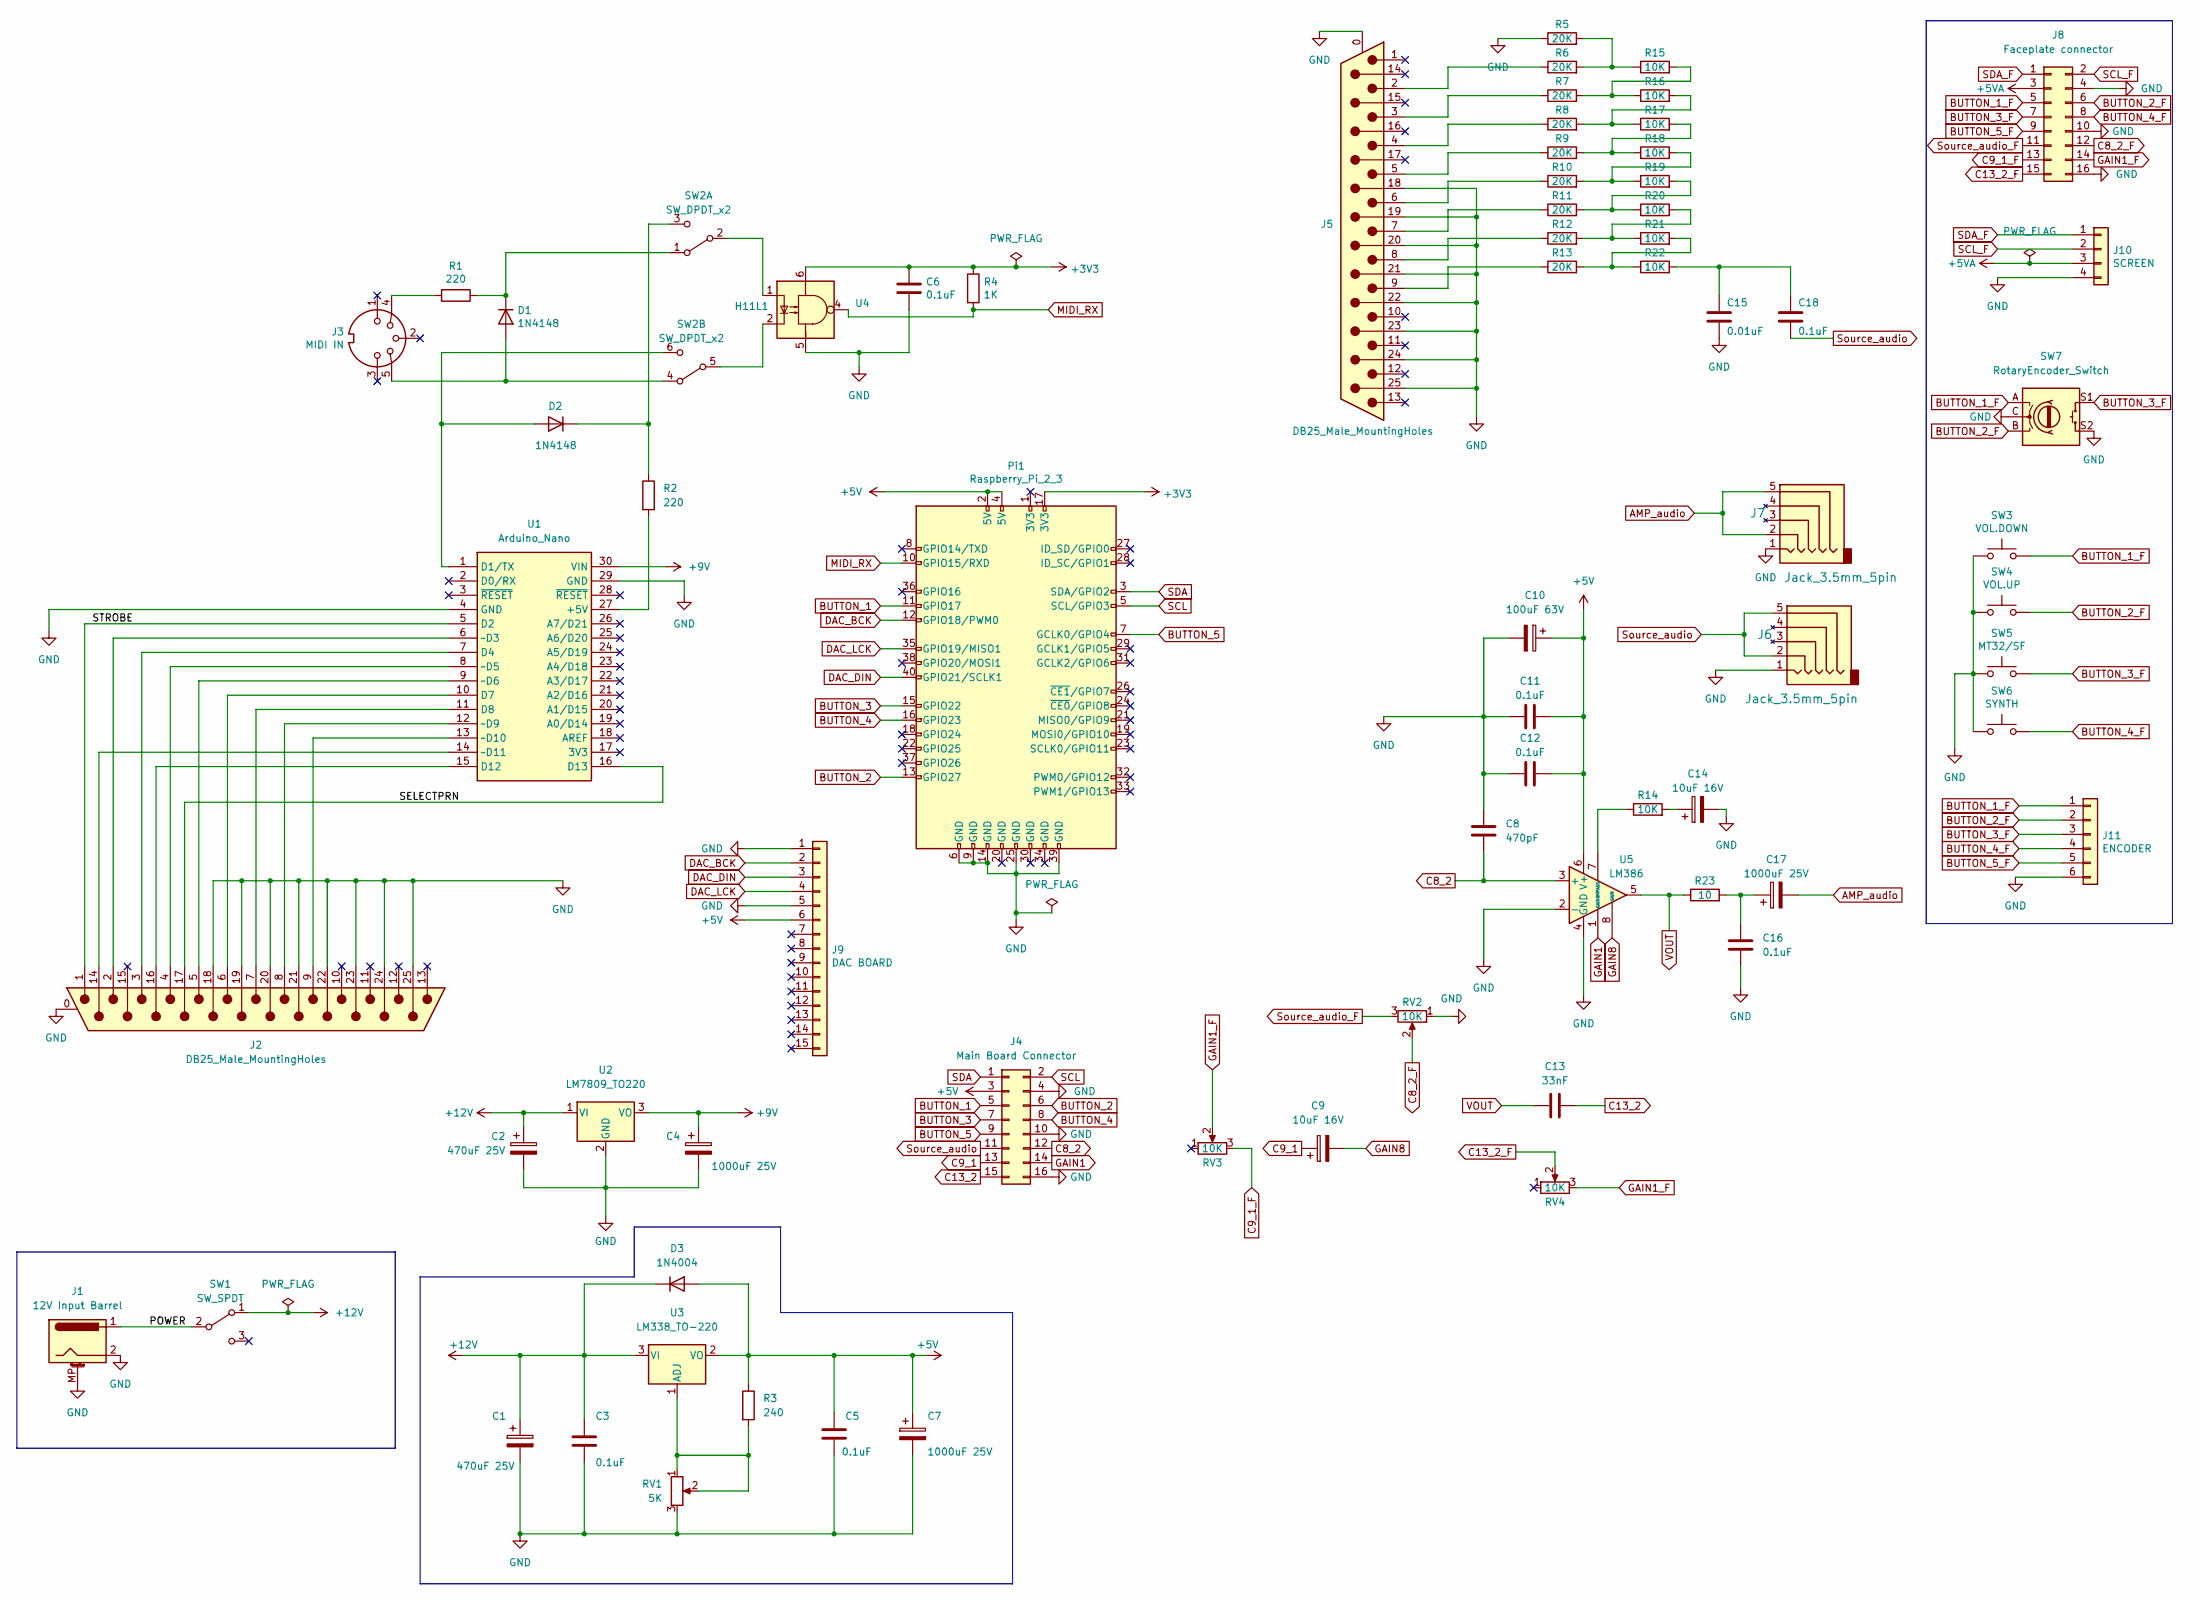
[picture p9: schematic retro_laptop_musicbox.kicad_sch, MIDI ЭМУЛЯТОР]

Parts:
C1, C2: 470uF 25V; CP_Radial_D10.0mm_P7.50mm
C3, C5, C6, C11, C12, C16, C18: 0.1uF; C_Disc_D4.7mm_W2.5mm_P5.00mm
C4, C7, C17: 1000uF 25V; CP_Radial_D10.0mm_P7.50mm
C8: 470pF; C_Disc_D4.7mm_W2.5mm_P5.00mm
C9, C14: 10uF 16V; CP_Radial_D5.0mm_P2.00mm
C10: 100uF 63V; CP_Radial_D10.0mm_P5.00mm
C13: 33nF; C_Disc_D4.7mm_W2.5mm_P5.00mm
C15: 0.01uF; C_Disc_D4.7mm_W2.5mm_P5.00mm
D1, D2: 1N4148; D_DO-35_SOD27_P7.62mm_Horizontal
D3: 1N4004; D_DO-41_SOD81_P10.16mm_Horizontal
J1: 12V Input Barrel; BarrelJack_GCT_DCJ200-10-A_Horizontal
J2, J5: DB25_Male_MountingHoles; DSUB-25_Male_Horizontal_P2.77x2.84mm_EdgePinOffset7.70mm_Ho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
J3: MIDI IN; DIN-5-Variable
J4: Main Board Connector; PinHeader_2x08_P2.54mm_Vertical
J6, J7: Jack_3.5mm_5pin; jack_5_pin_3f07_FINAL
J8: Faceplate connector; PinHeader_2x08_P2.54mm_Vertical
J9: DAC BOARD; PCM5102_full
J10: SCREEN; PinHeader_1x04_P2.54mm_Vertical
J11: ENCODER; PinHeader_1x06_P2.54mm_Vertical
Pi1: Raspberry_Pi_2_3; PinHeader_2x20_P2.54mm_Vertical
R1, R2: 220; R_Axial_DIN0207_L6.3mm_D2.5mm_P10.16mm_Horizontal
R3: 240; R_Axial_DIN0207_L6.3mm_D2.5mm_P10.16mm_Horizontal
R4: 1K; R_Axial_DIN0207_L6.3mm_D2.5mm_P10.16mm_Horizontal
R5, R6, R7, R8, R9, R10, R11, R12, R13: 20K; R_Axial_DIN0207_L6.3mm_D2.5mm_P10.16mm_Horizontal
R14, R15, R16, R17, R18, R19, R20, R21, R22: 10K; R_Axial_DIN0207_L6.3mm_D2.5mm_P10.16mm_Horizontal
R23: 10; R_Axial_DIN0207_L6.3mm_D2.5mm_P10.16mm_Horizontal
RV1: 5K; Potentiometer_Runtron_RM-065_Vertical
RV2, RV3, RV4: 10K; Potentiometer_Alpha_RD901F-40-00D_Single_Vertical_CircularH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
SW1: SW_SPDT; MTS-102-C3
SW2: SW_DPDT_x2; SW_CuK_JS202011AQN_DPDT_Angled2
SW3: VOL.DOWN; SW_PUSH_6mm
SW4: VOL.UP; SW_PUSH_6mm
SW5: MT32/SF; SW_PUSH_6mm
SW6: SYNTH; SW_PUSH_6mm
SW7: RotaryEncoder_Switch; RotaryEncoder_Alps_EC11E-Switch_Vertical_H20mm
U1: Arduino_Nano
U2: LM7809_TO220; TO-220-3_Vertical
U3: LM338_TO-220; TO-220-3_Vertical
U4: H11L1; DIP-6_W7.62mm
U5: LM386; DIP-8_W7.62mm

Connections:
+3V3: C6.1, Pi1.17 (3V3), R4.1, U4.6
+5V: C5.1, C7.1, C10.1, C11.2, C12.2, D3.2 (A), J4.3, J9.6, Pi1.2 (5V), Pi1.4 (5V), R3.1, U3.2 (VO), U5.6 (V+)
+5VA: J8.3, J10.3
+9V: C4.1, U1.30 (VIN), U2.3 (VO)
+12V: C1.1, C2.1, C3.1, D3.1 (K), SW1.1 (A), U2.1 (VI), U3.3 (VI)
/POWER: J1.1, SW1.2 (B)
/SELECTPRN: J2.17, U1.16 (D13)
/STROBE: J2.1, U1.5 (D2)
AMP_audio: C17.2, J7.2, J7.5
BUTTON_1: J4.5, Pi1.11 (GPIO17)
BUTTON_1_F: J8.5, J11.1, SW3.2, SW7.A
BUTTON_2: J4.6, Pi1.13 (GPIO27)
BUTTON_2_F: J8.6, J11.2, SW4.2, SW7.B
BUTTON_3: J4.7, Pi1.15 (GPIO22)
BUTTON_3_F: J8.7, J11.3, SW5.2, SW7.S1
BUTTON_4: J4.8, Pi1.16 (GPIO23)
BUTTON_4_F: J8.8, J11.4, SW6.2
BUTTON_5: J4.9, Pi1.7 (GCLK0/GPIO4)
BUTTON_5_F: J8.9, J11.5
C8_2: C8.2, J4.12, U5.3 (+)
C8_2_F: J8.12, RV2.2
C9_1: C9.1, J4.13
C9_1_F: J8.13, RV3.3
C13_2: C13.2, J4.15
C13_2_F: J8.15, RV4.2
DAC_BCK: J9.2, Pi1.12 (GPIO18/PWM0)
DAC_DIN: J9.3, Pi1.40 (GPIO21/SCLK1)
DAC_LCK: J9.4, Pi1.35 (GPIO19/MISO1)
GAIN1: J4.14, U5.1 (GAIN)
GAIN1_F: J8.14, RV3.2, RV4.3
GAIN8: C9.2, U5.8 (GAIN)
GND: C1.2, C2.2, C3.2, C4.2, C5.2, C6.2, C7.2, C8.1, C10.2, C11.1, C12.1, C14.2, C15.2, C16.2, J1.2, J1.MP (MountPin), J2.0 (PAD), J2.18, J2.19, J2.20, J2.21, J2.22, J2.23, J2.24, J2.25, J4.4, J4.10, J4.16, J5.0 (PAD), J5.18, J5.19, J5.20, J5.21, J5.22, J5.23, J5.24, J5.25, J6.1, J7.1, J8.4, J8.10, J8.16, J9.1, J9.5, J10.4, J11.6, Pi1.6 (GND), Pi1.9 (GND), Pi1.14 (GND), Pi1.25 (GND), Pi1.39 (GND), R5.1, RV1.3, RV2.1, SW7.C, SW7.S2, U1.4 (GND), U1.29 (GND), U2.2 (GND), U4.5, U5.2 (-), U5.4 (GND)
MIDI_RX: Pi1.10 (GPIO15/RXD), R4.2, U4.4
unnamed: C14.1, R14.2
unnamed: C15.1, C18.1, R22.2
unnamed: C16.1, C17.1, R23.2
unnamed: D1.1 (K), R1.1, SW2.1 (A)
unnamed: D1.2 (A), J3.5, SW2.4 (A)
unnamed: D2.1 (K), R2.1, SW2.3 (C)
unnamed: D2.2 (A), SW2.6 (C), U1.1 (D1/TX)
unnamed: J2.2, U1.6 (~D3)
unnamed: J2.3, U1.7 (D4)
unnamed: J2.4, U1.8 (~D5)
unnamed: J2.5, U1.9 (~D6)
unnamed: J2.6, U1.10 (D7)
unnamed: J2.7, U1.11 (D8)
unnamed: J2.8, U1.12 (~D9)
unnamed: J2.9, U1.13 (~D10)
unnamed: J2.14, U1.14 (~D11)
unnamed: J2.16, U1.15 (D12)
unnamed: J3.4, R1.2
unnamed: J5.2, R6.1
unnamed: J5.3, R7.1
unnamed: J5.4, R8.1
unnamed: J5.5, R9.1
unnamed: J5.6, R10.1
unnamed: J5.7, R11.1
unnamed: J5.8, R12.1
unnamed: J5.9, R13.1
unnamed: R2.2, U1.27 (+5V)
unnamed: R3.2, RV1.1, RV1.2, U3.1 (ADJ)
unnamed: R10.2, R18.2, R19.1
unnamed: R11.2, R19.2, R20.1
unnamed: R12.2, R20.2, R21.1
unnamed: R13.2, R21.2, R22.1
unnamed: R14.1, U5.7 (BYPASS)
unnamed: R5.2, R6.2, R15.1
unnamed: R7.2, R15.2, R16.1
unnamed: R8.2, R16.2, R17.1
unnamed: R9.2, R17.2, R18.1
unnamed: SW2.2 (B), U4.1
unnamed: SW2.5 (B), U4.2
unnamed: SW3.1, SW4.1, SW5.1, SW6.1
SCL: J4.2, Pi1.5 (SCL/GPIO3)
SCL_F: J8.2, J10.2
SDA: J4.1, Pi1.3 (SDA/GPIO2)
SDA_F: J8.1, J10.1
Source_audio: C18.2, J4.11, J6.2, J6.5
Source_audio_F: J8.11, RV2.3
VOUT: C13.1, R23.1, U5.5

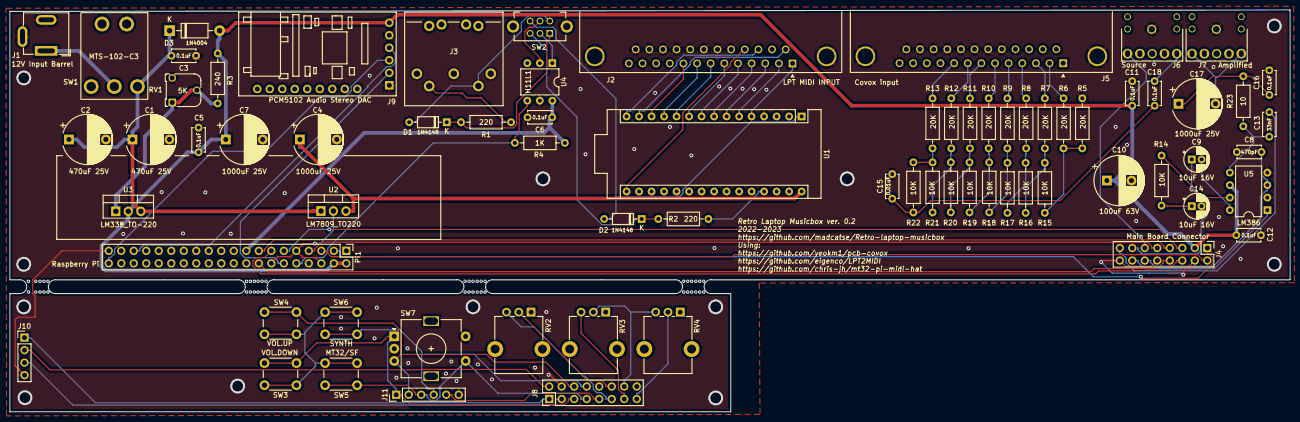
[picture p10: board retro_laptop_musicbox.kicad_pcb from above]

Board: 2 copper layers, 260.0 x 81.6 mm, 80 parts (0 on the bottom side), 80 nets.

Other parts of the board:
mouse-bite-2.54mm-slot_1, mouse-bite-2.54mm-slot_2, mouse-bite-2.54mm-slot_5, mouse-bite-2.54mm-slot_6, mouse-bite-2.54mm-slot_9, mouse-bite-2.54mm-slot_10, mouse-bite-2.54mm-slot_13, mouse-bite-2.54mm-slot_14: VAL**; mouse-bite-2.54mm-slot
