madcatse/Retro-laptop-musicbox/(commit log)

2023-03-17 Version 0.2
    Version 0.2
    [components_list.xlsx, my_pcb-B_Cu.dxf, my_pcb-B_Mask.dxf, my_pcb-B_Silkscreen.dxf, my_pcb-Edge_Cuts.dxf, my_pcb-F_Cu.dxf, my_pcb-F_Mask.dxf, my_pcb-F_Silkscreen.dxf]
2023-03-17 New gerbers
    [my_pcb-B_Cu.dxf, my_pcb-B_Mask.dxf, my_pcb-B_Silkscreen.dxf, my_pcb-Edge_Cuts.dxf, my_pcb-F_Cu.dxf, my_pcb-F_Mask.dxf, my_pcb-F_Silkscreen.dxf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]
2023-03-26 March 26th Update
    [retro_laptop_musicbox.dxf, retro_laptop_musicbox.kicad_sch, структурная_схема.dxf]
2023-06-03 Update June 2023
    [retro_laptop_musicbox.kicad_pcb]
2023-07-18 Update 19072023
    [CUI_DEVICES_SJ1-3523N.STL, minijack.STEP, retro_laptop_musicbox.kicad_pcb]
2026-05-26 Update Kicad 10
    [retro_laptop_musicbox.kicad_sch]
